jj-0/upd78c14-pico-reader/hw/BREADBOARD.md

# Breadboard build (one 830-point board)

Generated by `tools/gen_hw.py` from the same design table as the KiCad schematic; the script
flattens this layout into nets and checks they match the schematic exactly.

Hole names are `<row><column>` (rows 1–63, columns a–j). `L+`/`L-` are the rails next to column a,
`R+`/`R-` the rails next to column j. Rails are assumed continuous (bridge split rails).

## 1. Placement

| Part | Where | Notes |
|---|---|---|
| U1 µPD78C14GF on a QFP-64 (14×20 mm, 1.0 mm) → DIP-64 **900 mil** adapter, pin N = QFP pin N | pins 1–32 in column a rows 1–32, pins 33–64 in column h rows 32–1 | pin 1 = row 1. Mount it on stacked/long headers: the strips under it (columns b–g) are wired first |
| U2 74HCT04 | pins 1–7 in column e rows 34–40, pins 14–8 in column f rows 34–40 | notch toward row 33 |
| A1 Raspberry Pi Pico 2 | pins 21–40 in column c rows 43–62, pins 1–20 in column h rows 62–43 | USB connector toward row 63; it covers columns d–g |

## 2. Resistors and capacitors

R7–R23 land in column b of rows 1–18, under the edge of the U1 adapter: fit them (leads bent flat)
together with the group-2 jumpers **before** plugging in the adapter.

| Ref | Value | Lead 1 | Lead 2 | Net |
|---|---|---|---|---|
| R1 | 22k | R+ rail, row 6 | 6j | +5V / PA0 |
| R2 | 22k | R+ rail, row 5 | 5j | +5V / PA1 |
| R3 | 22k | R+ rail, row 4 | 4j | +5V / PA2 |
| R4 | 22k | R+ rail, row 3 | 3j | +5V / PA3 |
| R5 | 22k | R+ rail, row 2 | 2j | +5V / PA4 |
| R6 | 22k | R+ rail, row 1 | 1j | +5V / PA5 |
| R7 | 22k | L+ rail, row 1 | 1b | +5V / PA6 |
| R8 | 22k | L+ rail, row 2 | 2b | +5V / PA7 |
| R9 | 22k | L+ rail, row 3 | 3b | +5V / PB0 |
| R10 | 22k | L+ rail, row 4 | 4b | +5V / PB1 |
| R11 | 22k | L+ rail, row 5 | 5b | +5V / PB2 |
| R12 | 22k | L+ rail, row 6 | 6b | +5V / PB3 |
| R13 | 22k | L+ rail, row 7 | 7b | +5V / PB4 |
| R14 | 22k | L+ rail, row 8 | 8b | +5V / PB5 |
| R15 | 22k | L+ rail, row 9 | 9b | +5V / PB6 |
| R16 | 22k | L+ rail, row 10 | 10b | +5V / PB7 |
| R17 | 22k | L+ rail, row 12 | 12b | +5V / PC1 |
| R18 | 22k | L+ rail, row 13 | 13b | +5V / PC2 |
| R19 | 22k | L+ rail, row 14 | 14b | +5V / PC3 |
| R20 | 22k | L+ rail, row 15 | 15b | +5V / PC4 |
| R21 | 22k | L+ rail, row 16 | 16b | +5V / PC5 |
| R22 | 22k | L+ rail, row 17 | 17b | +5V / MODE1 |
| R23 | 22k | L+ rail, row 18 | 18b | +5V / MODE0 |
| R24 | 4.7k | 47a | L- rail, row 47 | RUN / GND |
| C1 | 100nF | 7j | R- rail, row 7 | +5V / GND |
| C2 | 100nF | 28j | R- rail, row 28 | +5V / GND |
| C3 | 100nF | 34j | R- rail, row 34 | +5V / GND |

## 3. Jumper wires (in build order)

| # | From | To | Net | Connects |
|---|---|---|---|---|
| 1 | 62b | L+ rail, row 62 | +5V | A1 pin 40 (A1.40) *(group 1 power)* |
| 2 | 60b | L- rail, row 60 | GND | A1 pin 38 (A1.38) *(group 1 power)* |
| 3 | L+ rail, row 63 | R+ rail, row 63 | +5V |  *(group 1 power)* |
| 4 | L- rail, row 61 | R- rail, row 60 | GND |  *(group 1 power)* |
| 5 | 19e | L+ rail, row 19 | +5V | U1 /NMI (U1.19) *(group 2 under adapter)* |
| 6 | 20e | L- rail, row 20 | GND | U1 INT1 (U1.20) *(group 2 under adapter)* |
| 7 | 26e | L- rail, row 26 | GND | U1 VSS (U1.26) *(group 2 under adapter)* |
| 8 | 27e | L- rail, row 27 | GND | U1 AVSS (U1.27) *(group 2 under adapter)* |
| 9 | 28e | L- rail, row 28 | GND | U1 AN0 (U1.28) *(group 2 under adapter)* |
| 10 | 29e | L- rail, row 29 | GND | U1 AN1 (U1.29) *(group 2 under adapter)* |
| 11 | 30e | L- rail, row 30 | GND | U1 AN2 (U1.30) *(group 2 under adapter)* |
| 12 | 31e | L- rail, row 31 | GND | U1 AN3 (U1.31) *(group 2 under adapter)* |
| 13 | 32e | L- rail, row 32 | GND | U1 AN4 (U1.32) *(group 2 under adapter)* |
| 21 | 23e | 18e | MODE0 | U1 MODE0 (U1.23) ↔ U1 PC7/CO1 (U1.18) *(group 2 under adapter)* |
| 22 | 21e | 17e | MODE1 | U1 MODE1 (U1.21) ↔ U1 PC6/CO0 (U1.17) *(group 2 under adapter)* |
| 14 | 8i | R+ rail, row 8 | +5V | U1 /STOP (U1.57) *(group 3 chip right side)* |
| 15 | 7i | R+ rail, row 7 | +5V | U1 VDD (U1.58) *(group 3 chip right side)* |
| 16 | 28i | R+ rail, row 28 | +5V | U1 AVDD (U1.37) *(group 3 chip right side)* |
| 17 | 29i | R- rail, row 29 | GND | U1 VAREF (U1.36) *(group 3 chip right side)* |
| 18 | 30i | R- rail, row 30 | GND | U1 AN7 (U1.35) *(group 3 chip right side)* |
| 19 | 31i | R- rail, row 31 | GND | U1 AN6 (U1.34) *(group 3 chip right side)* |
| 20 | 32i | R- rail, row 32 | GND | U1 AN5 (U1.33) *(group 3 chip right side)* |
| 23 | 40d | L- rail, row 40 | GND | U2 pin 7 (U2.7) *(group 4 74HCT04)* |
| 24 | 34i | R+ rail, row 34 | +5V | U2 pin 14 (U2.14) *(group 4 74HCT04)* |
| 25 | 37i | R- rail, row 37 | GND | U2 pin 11 (U2.11) *(group 4 74HCT04)* |
| 26 | 35i | R- rail, row 35 | GND | U2 pin 13 (U2.13) *(group 4 74HCT04)* |
| 27 | 35d | 36d | /CLK | U2 pin 2 (U2.2) ↔ U2 pin 3 (U2.3) *(group 4 74HCT04)* |
| 28 | 39d | 39i | RESET_INV | U2 pin 6 (U2.6) ↔ U2 pin 9 (U2.9) *(group 4 74HCT04)* |
| 29 | 35c | 24e | /CLK | U2 pin 2 (U2.2) ↔ U1 X2 (U1.24) *(group 5 clock+reset)* |
| 30 | 37d | 25e | CLK | U2 pin 4 (U2.4) ↔ U1 X1 (U1.25) *(group 5 clock+reset)* |
| 31 | 40i | 22e | /RESET | U2 pin 8 (U2.8) ↔ U1 /RESET (U1.22) *(group 5 clock+reset)* |
| 32 | 48b | 34d | CLK_PWM | A1 GP20 (A1.26) ↔ U2 pin 1 (U2.1) *(group 5 clock+reset)* |
| 33 | 47b | 38d | RUN | A1 GP19 (A1.25) ↔ U2 pin 5 (U2.5) *(group 5 clock+reset)* |
| 34 | 11e | 49b | TXD | U1 PC0/TxD (U1.11) ↔ A1 GP21 (A1.27) *(group 5 clock+reset)* |
| 35 | 25i | 43b | ALE | U1 ALE (U1.40) ↔ A1 GP16 (A1.21) *(group 6 bus)* |
| 36 | 27i | 44b | /RD | U1 /RD (U1.38) ↔ A1 GP17 (A1.22) *(group 6 bus)* |
| 37 | 16i | 62i | AD0 | U1 PD0 (U1.49) ↔ A1 GP0 (A1.1) *(group 6 bus)* |
| 38 | 15i | 61i | AD1 | U1 PD1 (U1.50) ↔ A1 GP1 (A1.2) *(group 6 bus)* |
| 39 | 14i | 59i | AD2 | U1 PD2 (U1.51) ↔ A1 GP2 (A1.4) *(group 6 bus)* |
| 40 | 13i | 58i | AD3 | U1 PD3 (U1.52) ↔ A1 GP3 (A1.5) *(group 6 bus)* |
| 41 | 12i | 57i | AD4 | U1 PD4 (U1.53) ↔ A1 GP4 (A1.6) *(group 6 bus)* |
| 42 | 11i | 56i | AD5 | U1 PD5 (U1.54) ↔ A1 GP5 (A1.7) *(group 6 bus)* |
| 43 | 10i | 54i | AD6 | U1 PD6 (U1.55) ↔ A1 GP6 (A1.9) *(group 6 bus)* |
| 44 | 9i | 53i | AD7 | U1 PD7 (U1.56) ↔ A1 GP7 (A1.10) *(group 6 bus)* |
| 45 | 24i | 52i | A8 | U1 PF0 (U1.41) ↔ A1 GP8 (A1.11) *(group 6 bus)* |
| 46 | 23i | 51i | A9 | U1 PF1 (U1.42) ↔ A1 GP9 (A1.12) *(group 6 bus)* |
| 47 | 22i | 49i | A10 | U1 PF2 (U1.43) ↔ A1 GP10 (A1.14) *(group 6 bus)* |
| 48 | 21i | 48i | A11 | U1 PF3 (U1.44) ↔ A1 GP11 (A1.15) *(group 6 bus)* |
| 49 | 20i | 47i | A12 | U1 PF4 (U1.45) ↔ A1 GP12 (A1.16) *(group 6 bus)* |
| 50 | 19i | 46i | A13 | U1 PF5 (U1.46) ↔ A1 GP13 (A1.17) *(group 6 bus)* |
| 51 | 18i | 44i | A14 | U1 PF6 (U1.47) ↔ A1 GP14 (A1.19) *(group 6 bus)* |

## 4. Before plugging in USB

- Meter: rails + to − not shorted; U1 pin 58 (VDD) and 37 (AVDD) read +5 V rail, 26/27 GND.
- MODE0 (U1 23) and PC7 (U1 18) are one net; MODE1 (21) and PC6 (17) are one net; both pulled up.
- U1 pins left open on purpose: 39 /WR, 48 PF7 (A15).
- Keep the clock jumpers (U2.4 → X1, U2.2 → X2) short and away from the bus wires.
