jj-0/upd78c14-pico-reader/hw/breadboard.png

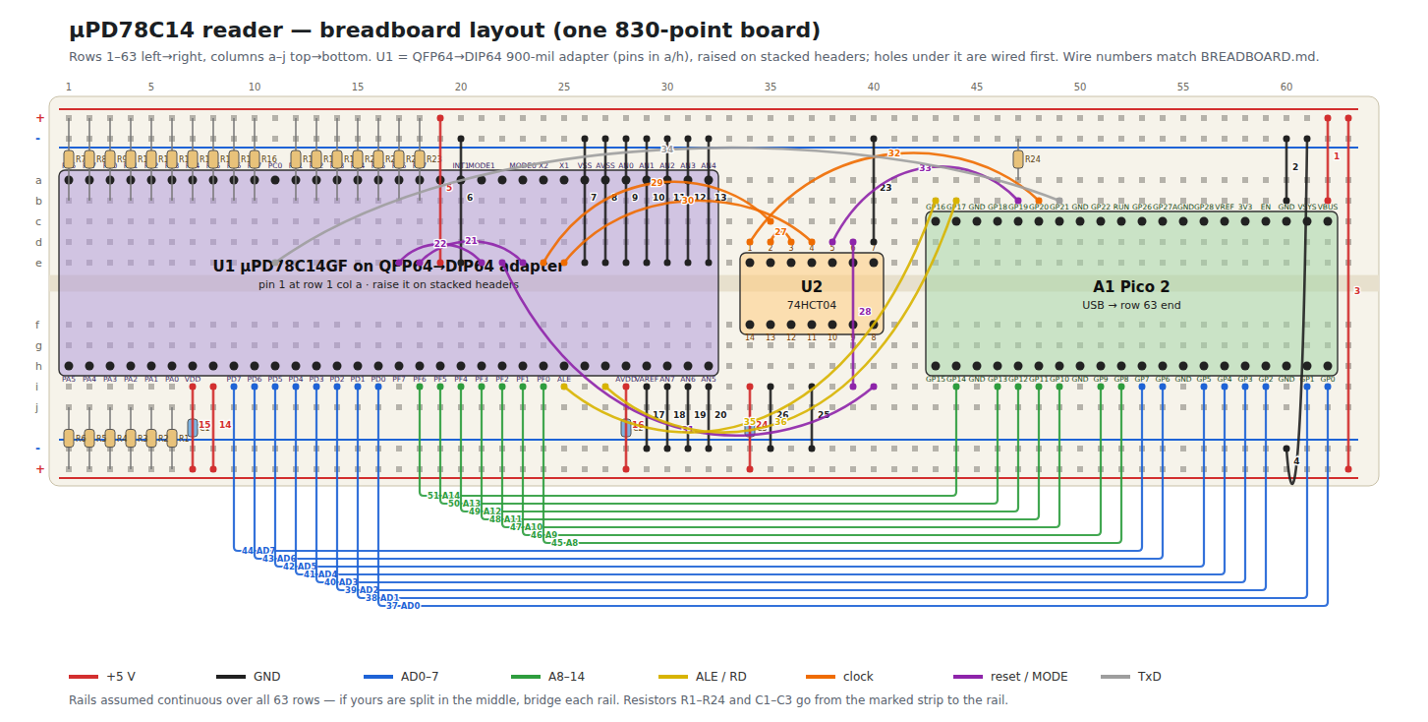
hw/breadboard.png
