jj-0/upd78c14-pico-reader/hw/schematic.png

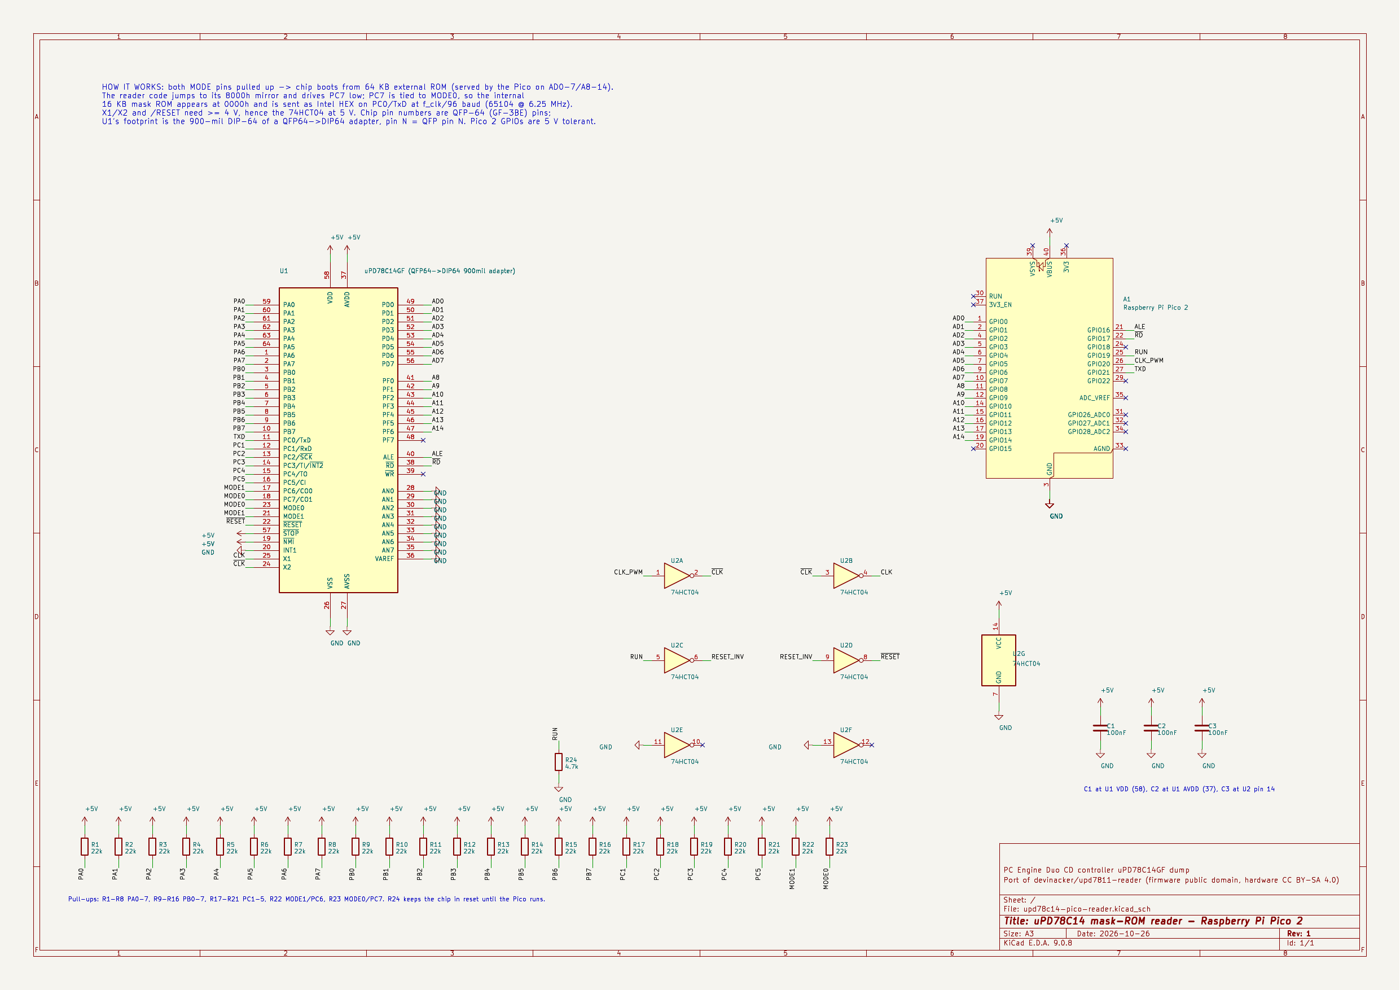
hw/schematic.png
