jj-0/upd78c14-pico-reader/WIRING.md

# Wiring: Pico 2 ↔ µPD78C14GF (QFP-64)

Generated by `tools/gen_wiring.py` (same table as `wiring.svg`).

## Signals

| Pico GPIO | Pico pin | µPD78C14 signal | QFP pin | Via | Note |
|---|---|---|---|---|---|
| GP0 | 1 | PD0 / AD0 | 49 | 470 Ω (optional) | address/data bus |
| GP1 | 2 | PD1 / AD1 | 50 | 470 Ω (optional) | address/data bus |
| GP2 | 4 | PD2 / AD2 | 51 | 470 Ω (optional) | address/data bus |
| GP3 | 5 | PD3 / AD3 | 52 | 470 Ω (optional) | address/data bus |
| GP4 | 6 | PD4 / AD4 | 53 | 470 Ω (optional) | address/data bus |
| GP5 | 7 | PD5 / AD5 | 54 | 470 Ω (optional) | address/data bus |
| GP6 | 9 | PD6 / AD6 | 55 | 470 Ω (optional) | address/data bus |
| GP7 | 10 | PD7 / AD7 | 56 | 470 Ω (optional) | address/data bus |
| GP8 | 11 | PF0 / A8 | 41 | 470 Ω (optional) | address bus |
| GP9 | 12 | PF1 / A9 | 42 | 470 Ω (optional) | address bus |
| GP10 | 14 | PF2 / A10 | 43 | 470 Ω (optional) | address bus |
| GP11 | 15 | PF3 / A11 | 44 | 470 Ω (optional) | address bus |
| GP12 | 16 | PF4 / A12 | 45 | 470 Ω (optional) | address bus |
| GP13 | 17 | PF5 / A13 | 46 | 470 Ω (optional) | address bus |
| GP14 | 19 | PF6 / A14 | 47 | 470 Ω (optional) | address bus |
| GP16 | 21 | ALE | 40 | 470 Ω (optional) | address latch enable |
| GP17 | 22 | /RD | 38 | 470 Ω (optional) | read strobe |
| GP21 | 27 | PC0 / TxD | 11 | 470 Ω (optional) | serial dump out (UART1 RX) |
| GP20 | 26 | X2 | 24 | 74HCT04 1A(1)→1Y(2) | clock, inverted |
| GP20 | 26 | X1 | 25 | 74HCT04 1Y(2)→2A(3), 2Y(4) | clock 6.25 MHz |
| GP19 | 25 | /RESET | 22 | 74HCT04 3A(5)→3Y(6)→4A(9), 4Y(8) | high = run; 4.7 kΩ GP19→GND |

## Power and static

| Connection | Pins |
|---|---|
| +5 V (Pico VBUS, pin 40) | VDD 58, AVDD 37, /STOP 57, /NMI 19, 74HCT04 pin 14 |
| GND (Pico pin 38) | VSS 26, AVSS 27, INT1 20, VAREF 36, AN0 28, AN1 29, AN2 30, AN3 31, AN4 32, AN5 33, AN6 34, AN7 35, 74HCT04 pin 7, 74HCT04 unused inputs 11, 13 |
| MODE0 23 ⟷ PC7 18 | plus 22 kΩ to +5 V |
| MODE1 21 ⟷ PC6 17 | plus 22 kΩ to +5 V |
| 22 kΩ pull-ups to +5 V | PA0 59, PA1 60, PA2 61, PA3 62, PA4 63, PA5 64, PA6 1, PA7 2, PB0 3, PB1 4, PB2 5, PB3 6, PB4 7, PB5 8, PB6 9, PB7 10, PC1 12, PC2 13, PC3 14, PC4 15, PC5 16 |
| Leave open | /WR 39, PF7 / A15 48 |
| Decoupling | 100 nF at VDD 58, AVDD 37 and the 74HCT04 |
| Optional LED | +5 V → LED → 1 kΩ → PC5 16 |
