jj-0/upd78c14-pico-reader/wiring.png

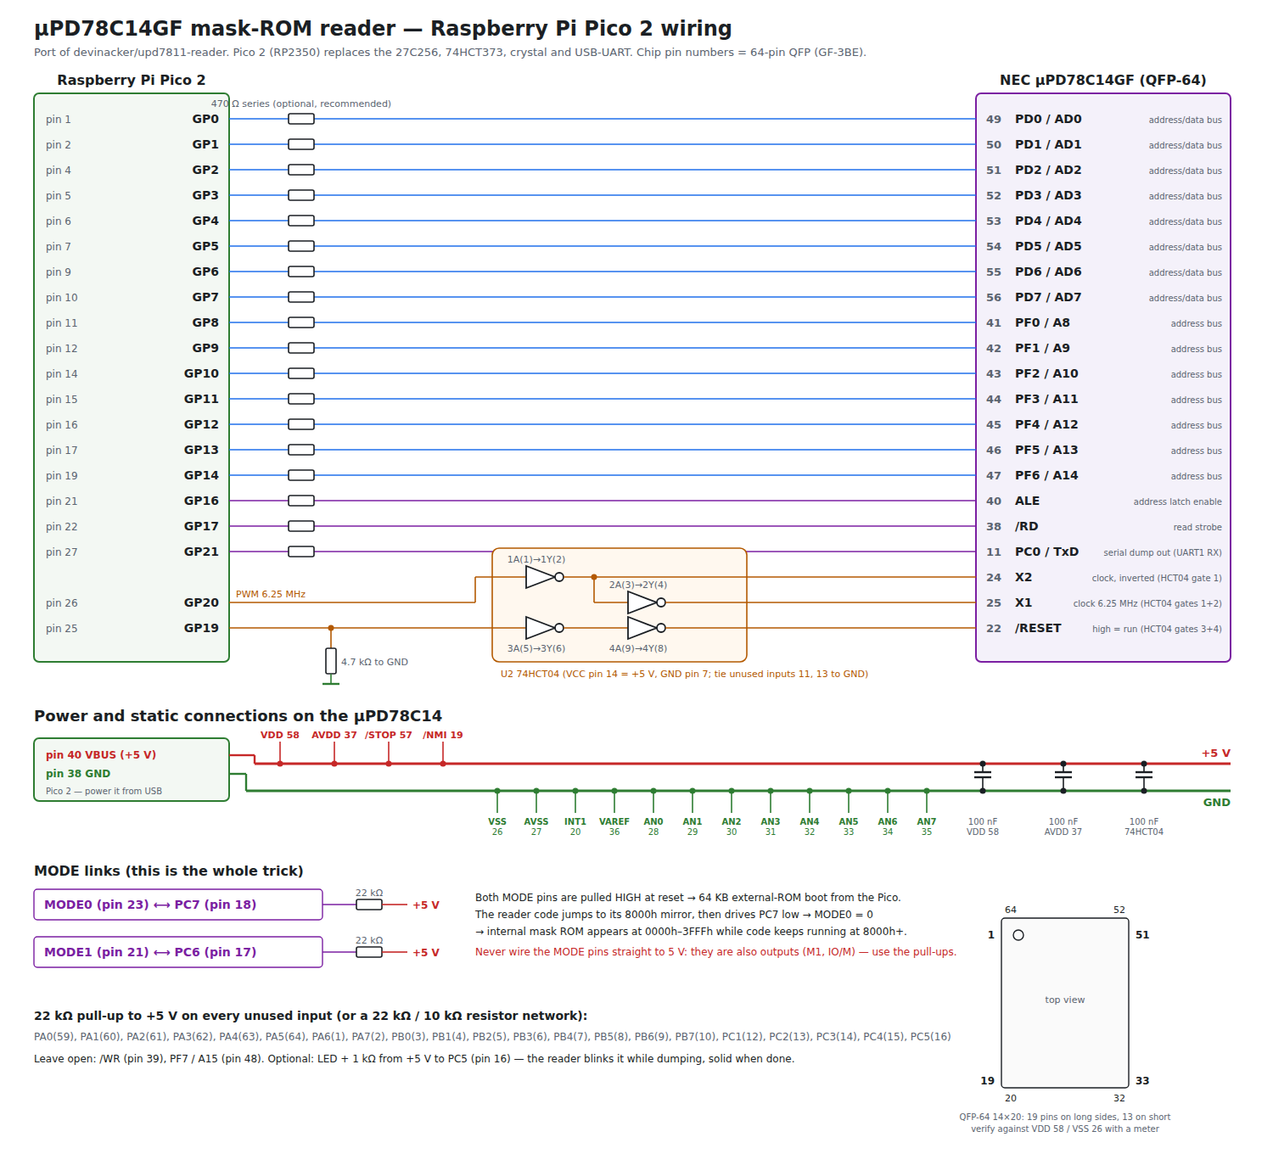
wiring.png
