jj-0/upd78c14-pico-reader/hw/upd78c14-pico-reader.pdf

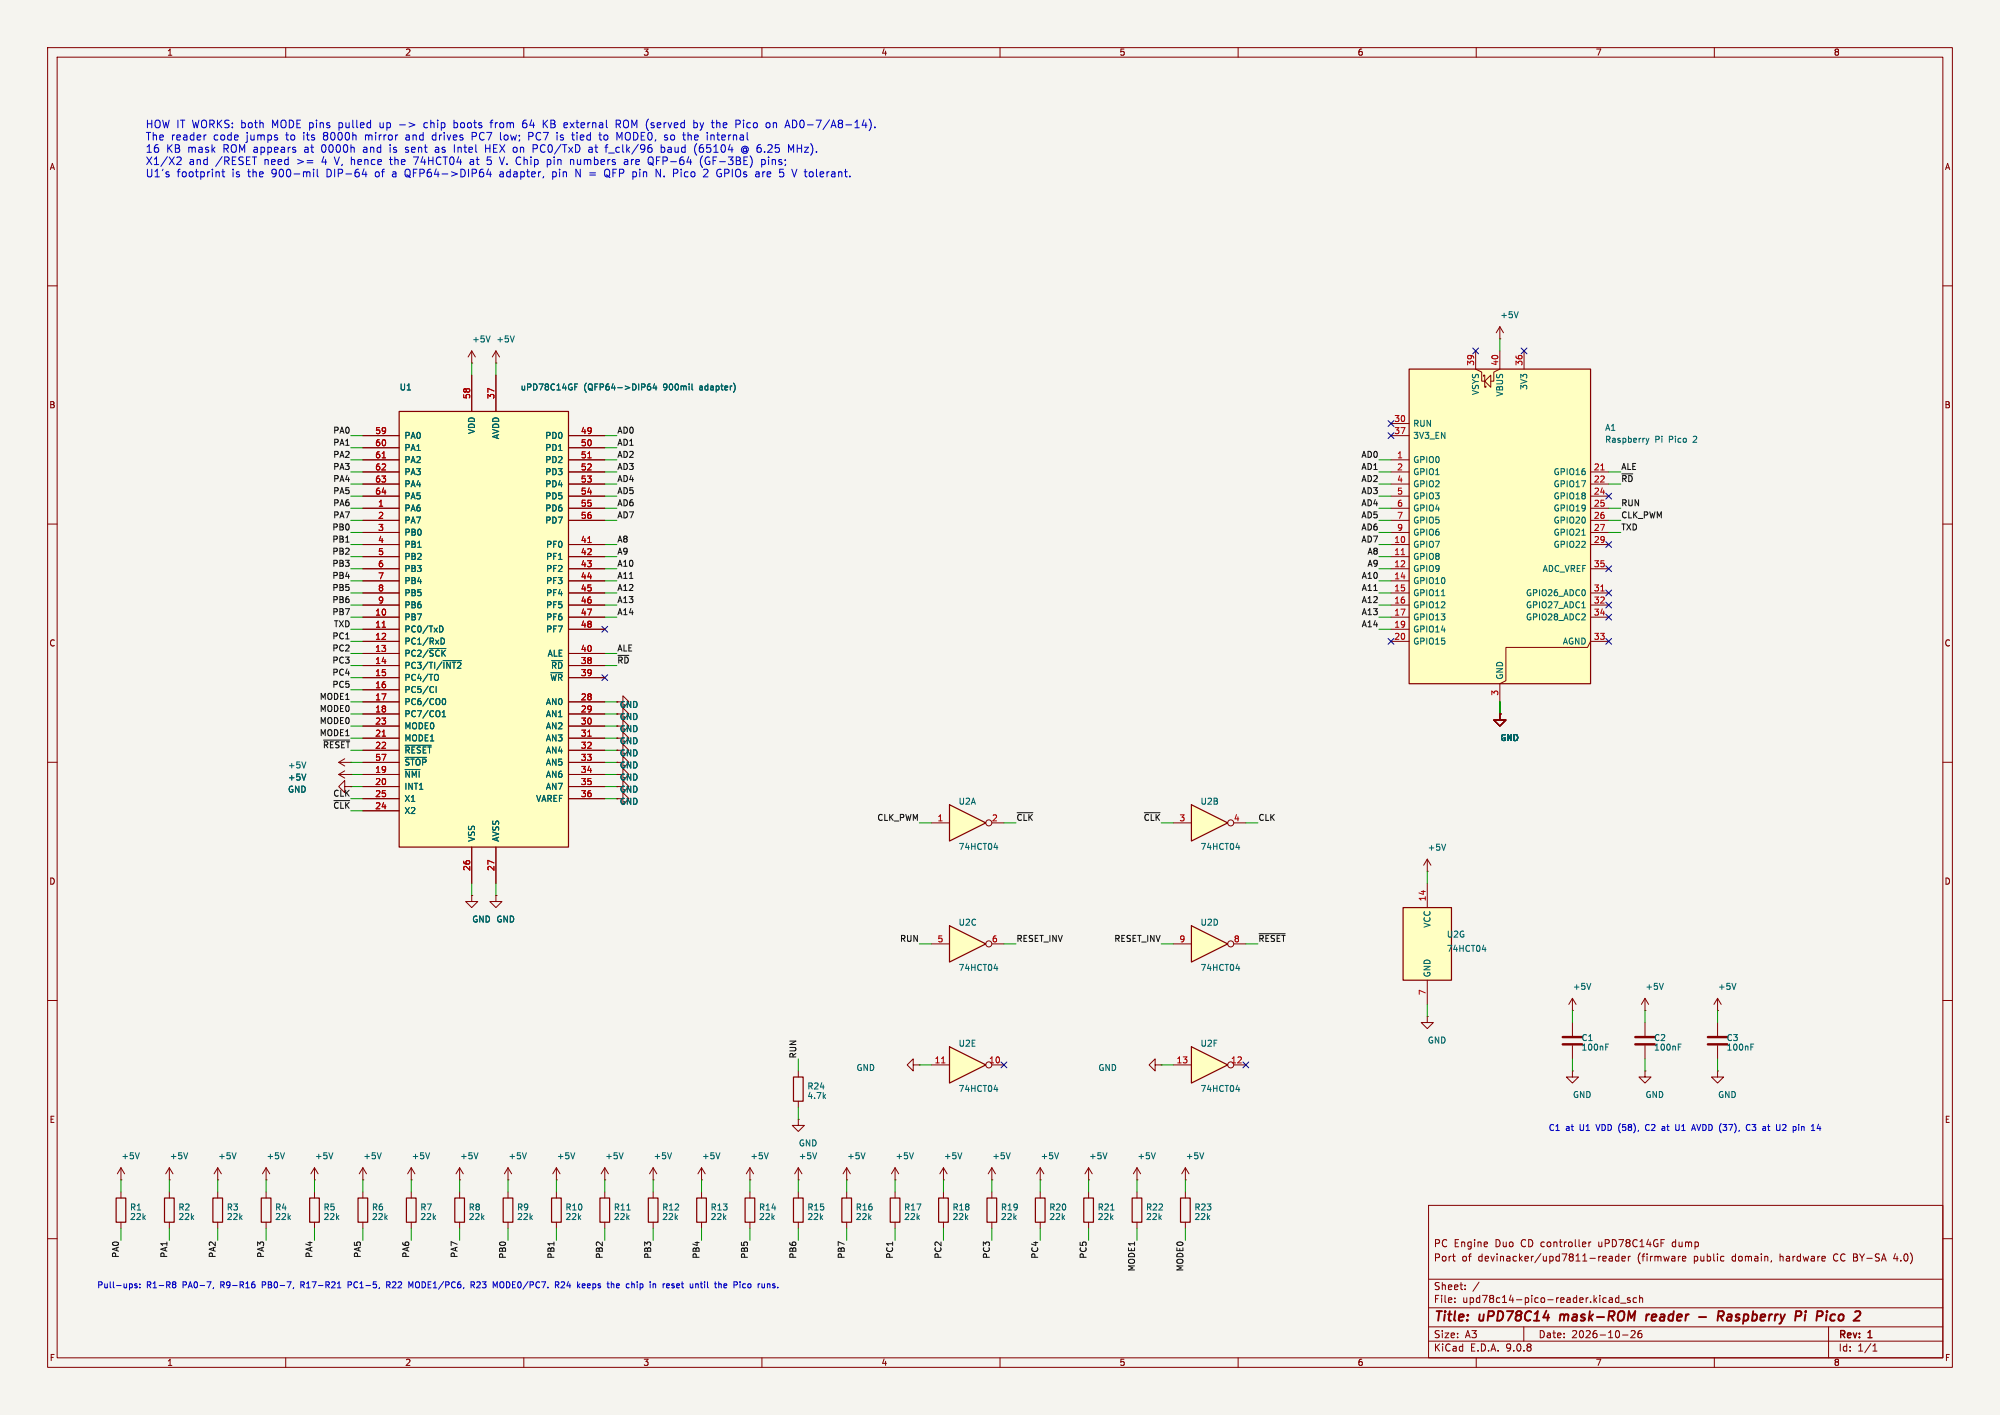
[picture p4: page 1]

The reader code jumps to its 8000h mirror and drives PC7 low; PC7 is tied to MODE0, so the internal
