jj-0/upd78c14-pico-reader/upstream/upd7811-reader.pdf

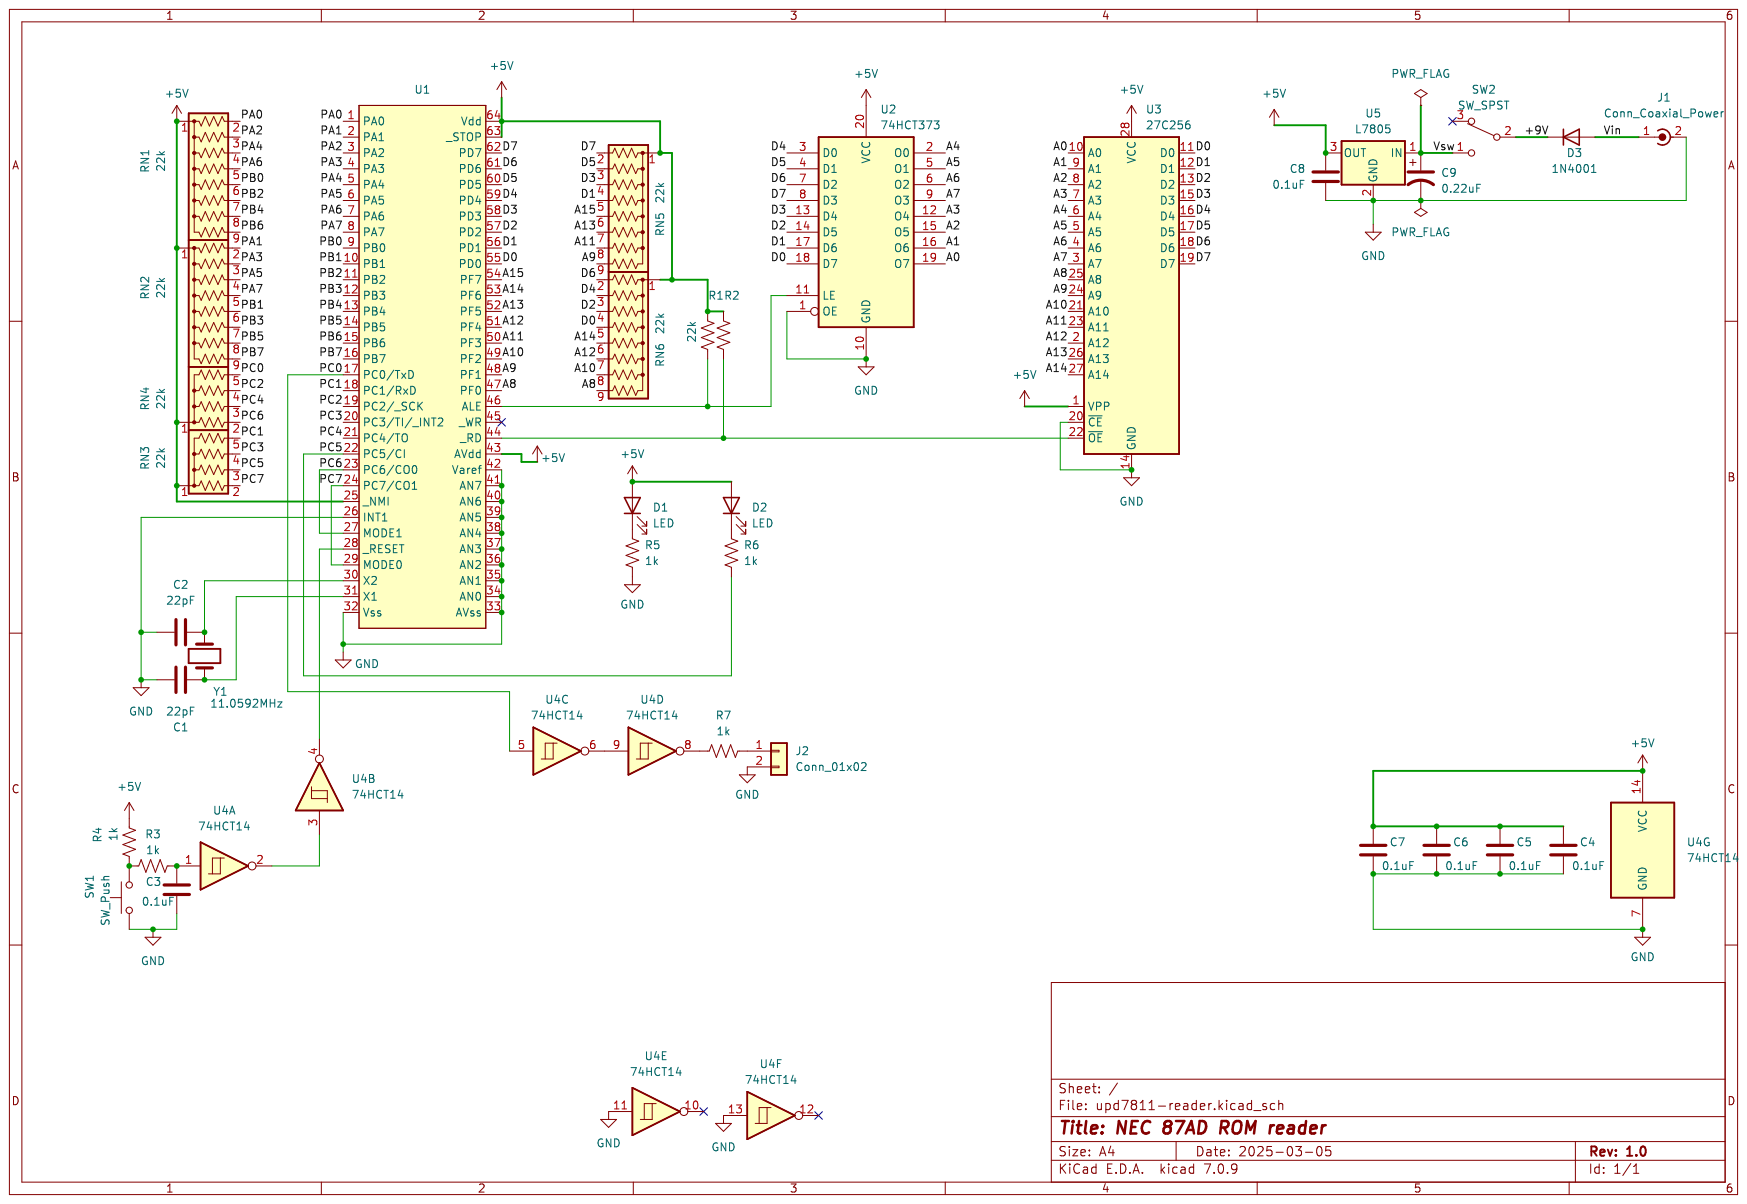
[picture p5: page 1]
