jj-0/upd78c14-pico-reader/hw/upd78c14-pico-reader.kicad_sch

## KiCad design hw/upd78c14-pico-reader.kicad_sch (2026-10-26)

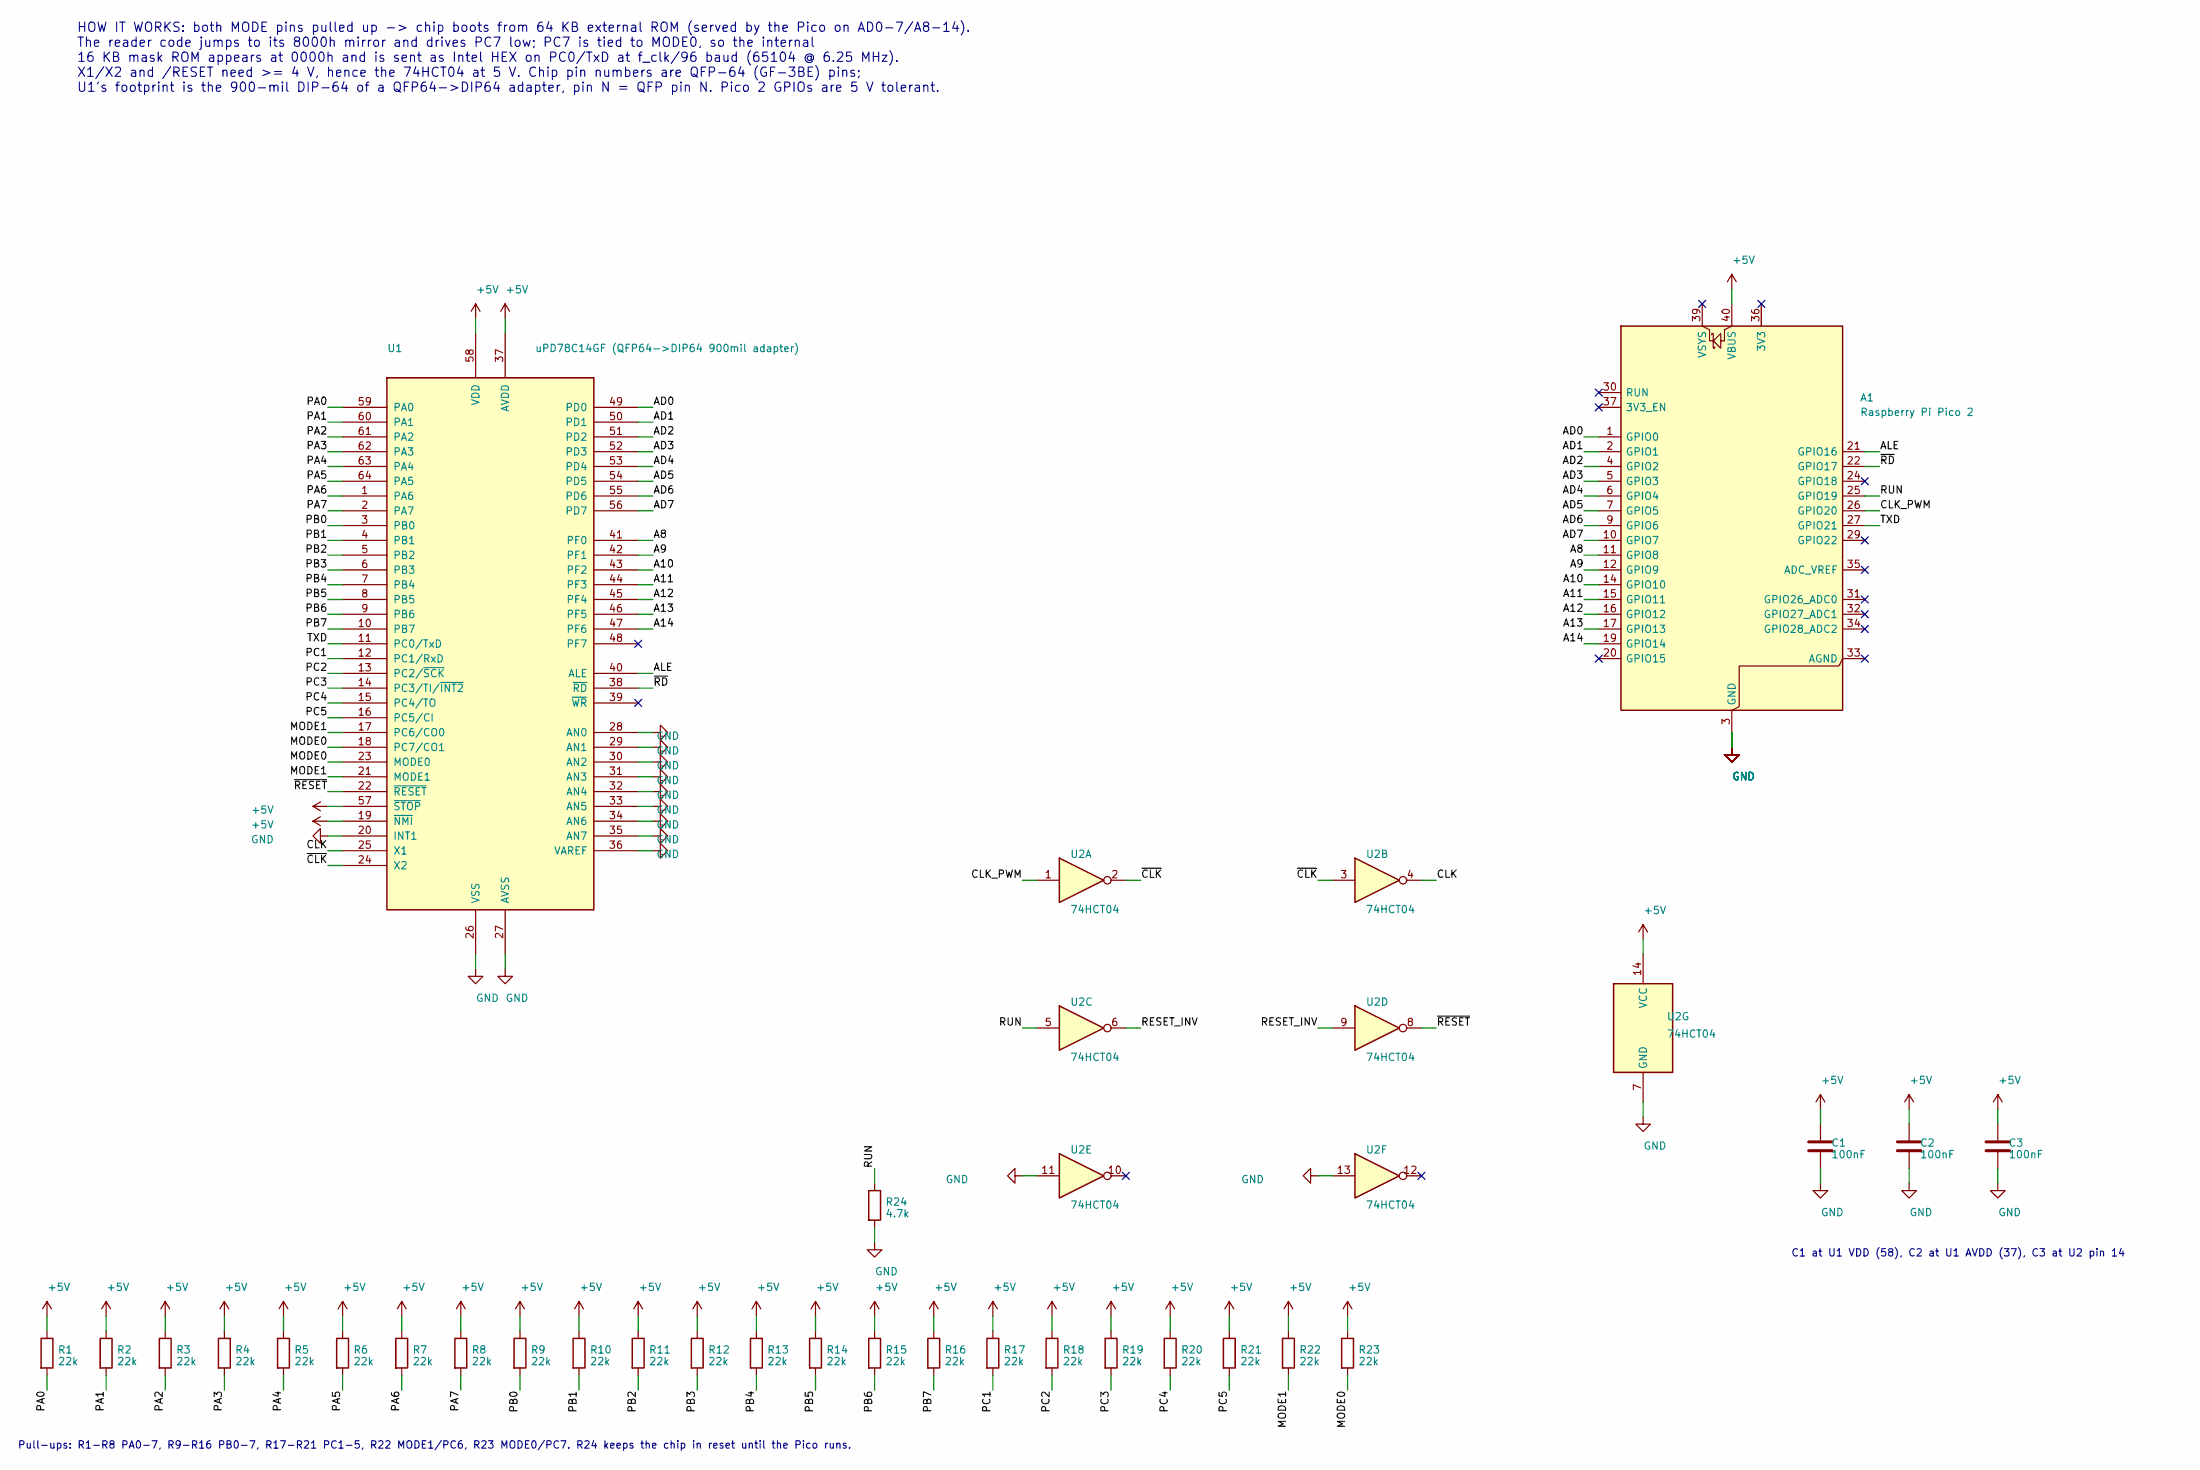
[picture p6: schematic upd78c14-pico-reader.kicad_sch]

Parts:
A1: Raspberry Pi Pico 2; RaspberryPi_Pico_Common_THT
C1, C2, C3: 100nF; C_Disc_D5.0mm_W2.5mm_P5.00mm
R1, R2, R3, R4, R5, R6, R7, R8, R9, R10, R11, R12, R13, R14, R15, R16, R17, R18, R19, R20, R21, R22, R23: 22k; R_Axial_DIN0207_L6.3mm_D2.5mm_P10.16mm_Horizontal
R24: 4.7k; R_Axial_DIN0207_L6.3mm_D2.5mm_P10.16mm_Horizontal
U1: uPD78C14GF (QFP64->DIP64 900mil adapter); DIP-64_W22.86mm
U2: 74HCT04; DIP-14_W7.62mm

Connections:
+5V: A1.40 (VBUS), C1.1, C2.1, C3.1, R1.1, R2.1, R3.1, R4.1, R5.1, R6.1, R7.1, R8.1, R9.1, R10.1, R11.1, R12.1, R13.1, R14.1, R15.1, R16.1, R17.1, R18.1, R19.1, R20.1, R21.1, R22.1, R23.1, U1.19 (~NMI), U1.37 (AVDD), U1.57 (~STOP), U1.58 (VDD), U2.14 (VCC)
A8: A1.11 (GPIO8), U1.41 (PF0)
A9: A1.12 (GPIO9), U1.42 (PF1)
A10: A1.14 (GPIO10), U1.43 (PF2)
A11: A1.15 (GPIO11), U1.44 (PF3)
A12: A1.16 (GPIO12), U1.45 (PF4)
A13: A1.17 (GPIO13), U1.46 (PF5)
A14: A1.19 (GPIO14), U1.47 (PF6)
AD0: A1.1 (GPIO0), U1.49 (PD0)
AD1: A1.2 (GPIO1), U1.50 (PD1)
AD2: A1.4 (GPIO2), U1.51 (PD2)
AD3: A1.5 (GPIO3), U1.52 (PD3)
AD4: A1.6 (GPIO4), U1.53 (PD4)
AD5: A1.7 (GPIO5), U1.54 (PD5)
AD6: A1.9 (GPIO6), U1.55 (PD6)
AD7: A1.10 (GPIO7), U1.56 (PD7)
ALE: A1.21 (GPIO16), U1.40 (ALE)
CLK: U1.25 (X1), U2.4
CLK_PWM: A1.26 (GPIO20), U2.1
GND: A1.3 (GND), A1.8 (GND), A1.13 (GND), A1.18 (GND), A1.23 (GND), A1.28 (GND), A1.38 (GND), C1.2, C2.2, C3.2, R24.2, U1.20 (INT1), U1.26 (VSS), U1.27 (AVSS), U1.28 (AN0), U1.29 (AN1), U1.30 (AN2), U1.31 (AN3), U1.32 (AN4), U1.33 (AN5), U1.34 (AN6), U1.35 (AN7), U1.36 (VAREF), U2.7 (GND), U2.11, U2.13
MODE0: R23.2, U1.18 (PC7/CO1), U1.23 (MODE0)
MODE1: R22.2, U1.17 (PC6/CO0), U1.21 (MODE1)
PA0: R1.2, U1.59 (PA0)
PA1: R2.2, U1.60 (PA1)
PA2: R3.2, U1.61 (PA2)
PA3: R4.2, U1.62 (PA3)
PA4: R5.2, U1.63 (PA4)
PA5: R6.2, U1.64 (PA5)
PA6: R7.2, U1.1 (PA6)
PA7: R8.2, U1.2 (PA7)
PB0: R9.2, U1.3 (PB0)
PB1: R10.2, U1.4 (PB1)
PB2: R11.2, U1.5 (PB2)
PB3: R12.2, U1.6 (PB3)
PB4: R13.2, U1.7 (PB4)
PB5: R14.2, U1.8 (PB5)
PB6: R15.2, U1.9 (PB6)
PB7: R16.2, U1.10 (PB7)
PC1: R17.2, U1.12 (PC1/RxD)
PC2: R18.2, U1.13 (PC2/~SCK)
PC3: R19.2, U1.14 (PC3/TI/~INT2)
PC4: R20.2, U1.15 (PC4/TO)
PC5: R21.2, U1.16 (PC5/CI)
RESET_INV: U2.6, U2.9
RUN: A1.25 (GPIO19), R24.1, U2.5
TXD: A1.27 (GPIO21), U1.11 (PC0/TxD)
~CLK: U1.24 (X2), U2.2, U2.3
~RD: A1.22 (GPIO17), U1.38 (~RD)
~RESET: U1.22 (~RESET), U2.8

Notes on the sheet:
C1 at U1 VDD (58), C2 at U1 AVDD (37), C3 at U2 pin 14
Pull-ups: R1-R8 PA0-7, R9-R16 PB0-7, R17-R21 PC1-5, R22 MODE1/PC6, R23 MODE0/PC7. R24 keeps the chip in reset until the Pico runs.
HOW IT WORKS: both MODE pins pulled up -> chip boots from 64 KB external ROM (served by the Pico on AD0-7/A8-14). The reader code jumps to its 8000h mirror and drives PC7 low; PC7 is tied to MODE0, so the internal 16 KB mask ROM appears at 0000h and is sent as Intel HEX on PC0/TxD at f_clk/96 baud 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
